AkshayLaddha943/Spherical-Bot/PCB files/PCB files/DATASHEETS/Motor driver TB66FNG-Robu/eagle_files for TB6612FNG/Readme.txt

The procurement of motordriver was done from Robu.in here https://robu.in/product/motor-driver-tb6612fng-module-performance-ultra-small-volume-3-pi-matching-performance-ultra-l298n/

But due to lack of required documentation on robu the similar product is available on spark fun here https://www.sparkfun.com/products/14451

I have provided the documents for the same of spark fun assuming the product to be same please go throught both for any query get in touch with me 
-Vaibhav N. Kadam
 7021781640/8976712648
 vaibhav02kadam@gmail.com/@iitb.ac.in
