AkshayLaddha943/Spherical-Bot/imgs/rpy_updated_2.PNG

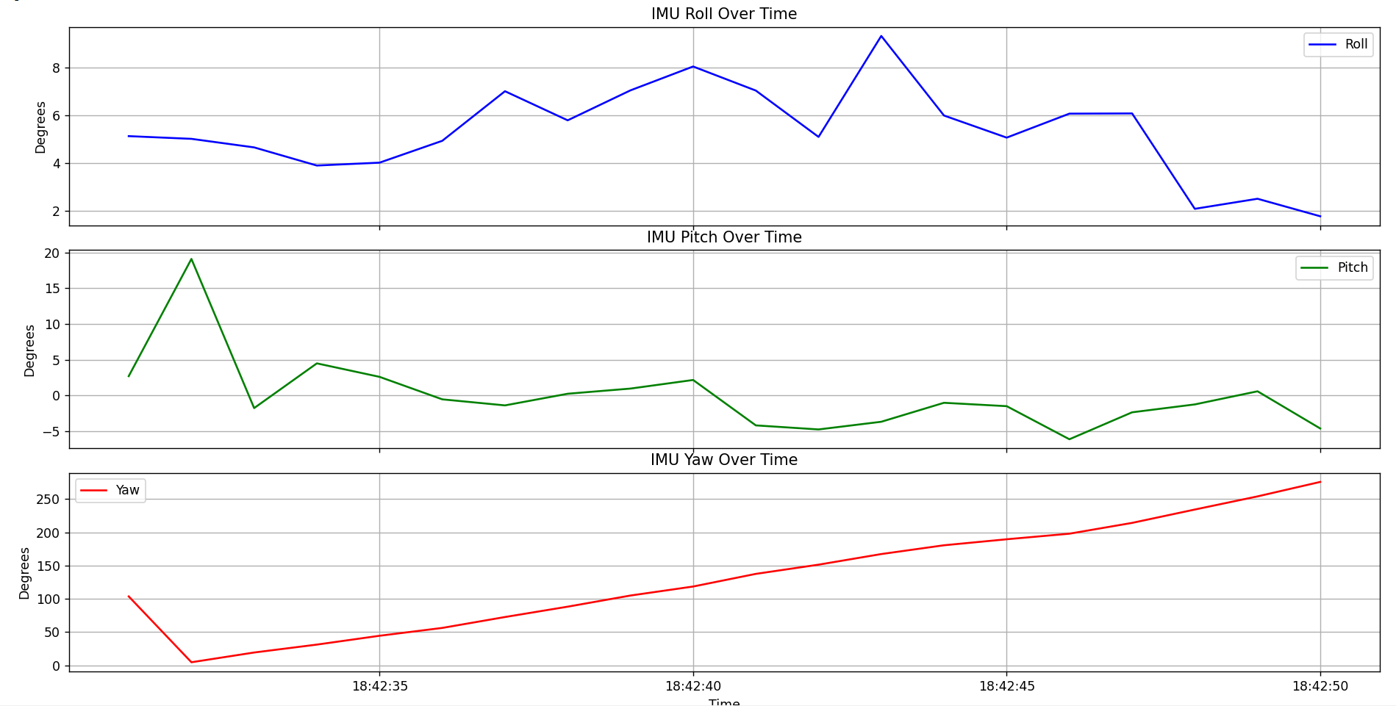
imgs/rpy_updated_2.PNG
