AkshayLaddha943/Spherical-Bot/PCB files/PCB files/DATASHEETS/0J4240.610_vSfLFW.jpeg

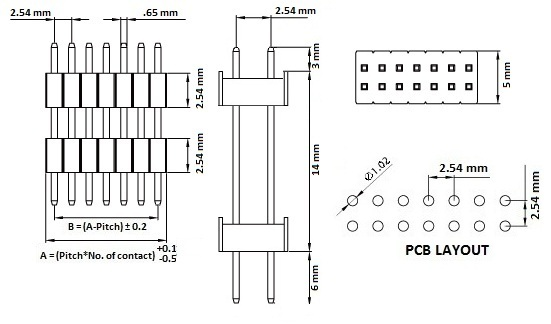
PCB files/PCB files/DATASHEETS/0J4240.610_vSfLFW.jpeg
