AkshayLaddha943/Spherical-Bot/PCB files/PCB files/DATASHEETS/41yIVpFrQML.jpeg.jpg

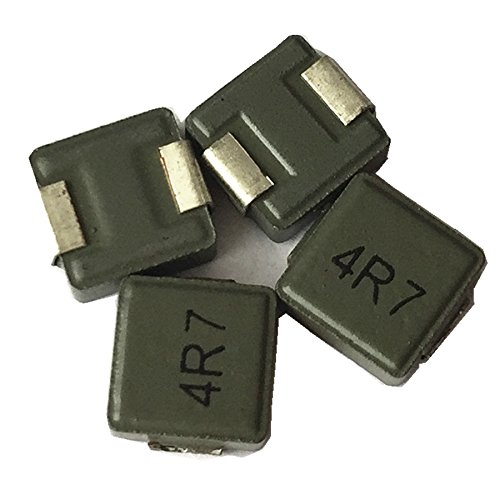
PCB files/PCB files/DATASHEETS/41yIVpFrQML.jpeg.jpg
