AkshayLaddha943/Spherical-Bot/PCB files/PCB files/DATASHEETS/adcpi_mechanical.png

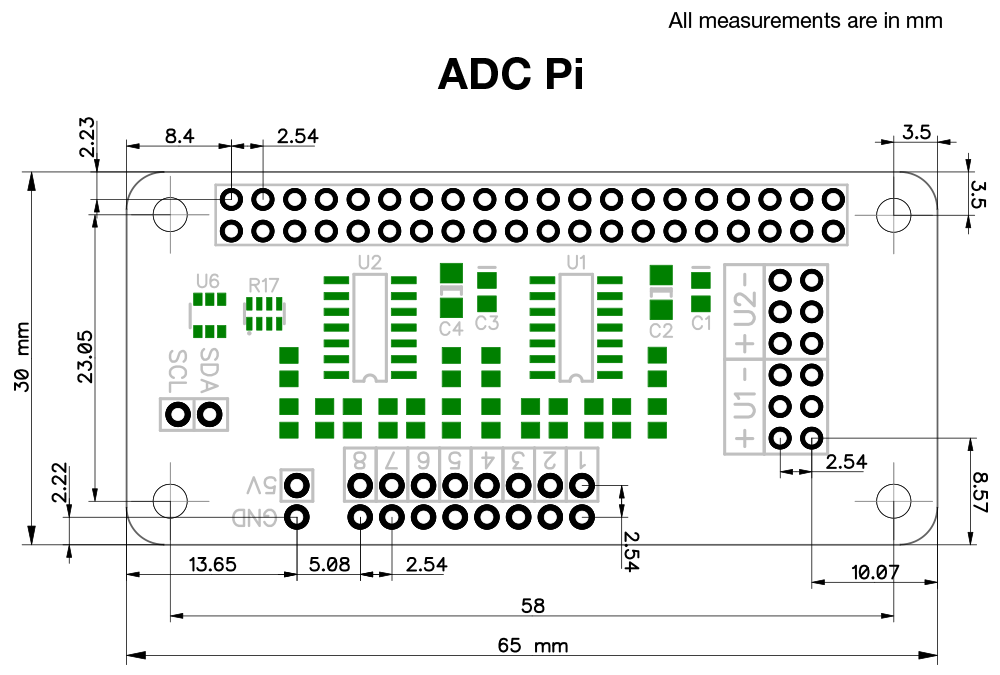
PCB files/PCB files/DATASHEETS/adcpi_mechanical.png
