AkshayLaddha943/Spherical-Bot/PCB files/PCB files/DATASHEETS/Barrel jack female Charging supply/footprint.png

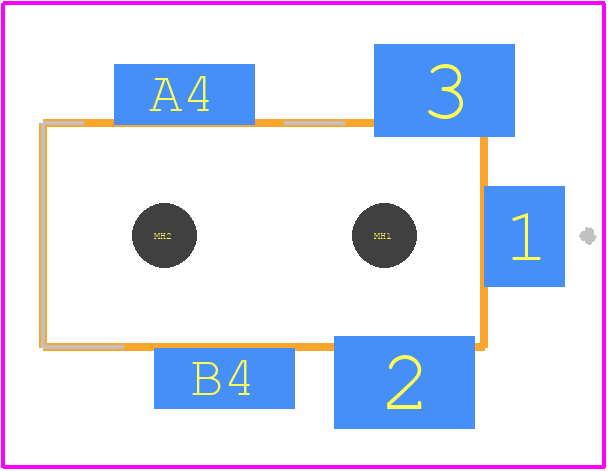
PCB files/PCB files/DATASHEETS/Barrel jack female Charging supply/footprint.png
