AkshayLaddha943/Spherical-Bot/PCB files/PCB files/DATASHEETS/DIP SW/upload_105_295_23274611.jpg

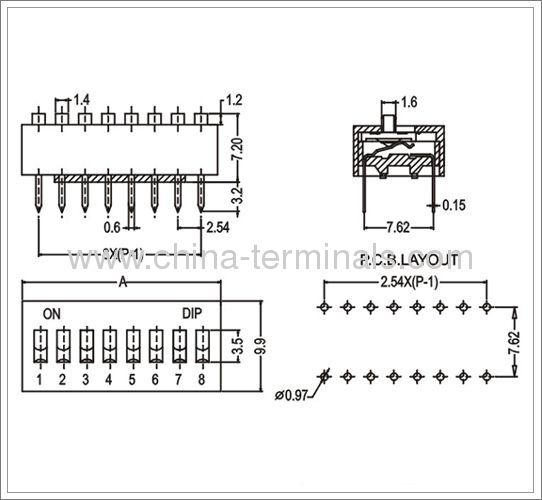
PCB files/PCB files/DATASHEETS/DIP SW/upload_105_295_23274611.jpg
