AkshayLaddha943/Spherical-Bot/PCB files/PCB files/DATASHEETS/power-jack-symbol.png

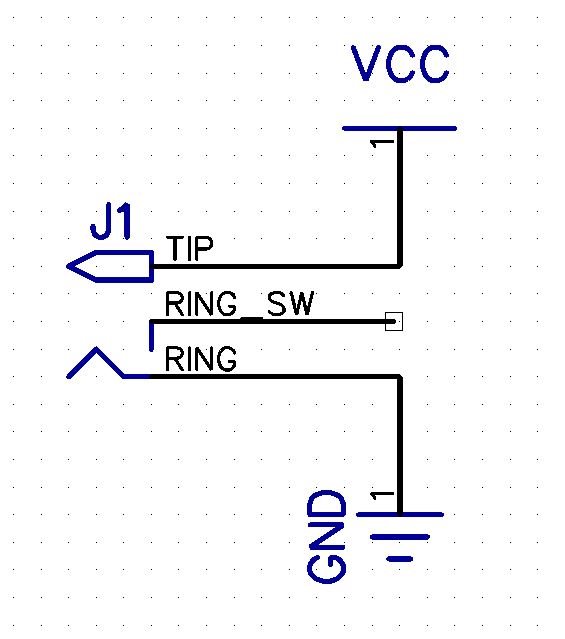
PCB files/PCB files/DATASHEETS/power-jack-symbol.png
