AkshayLaddha943/Spherical-Bot/PCB files/PCB files/LAYOUT/Bottom.jpeg

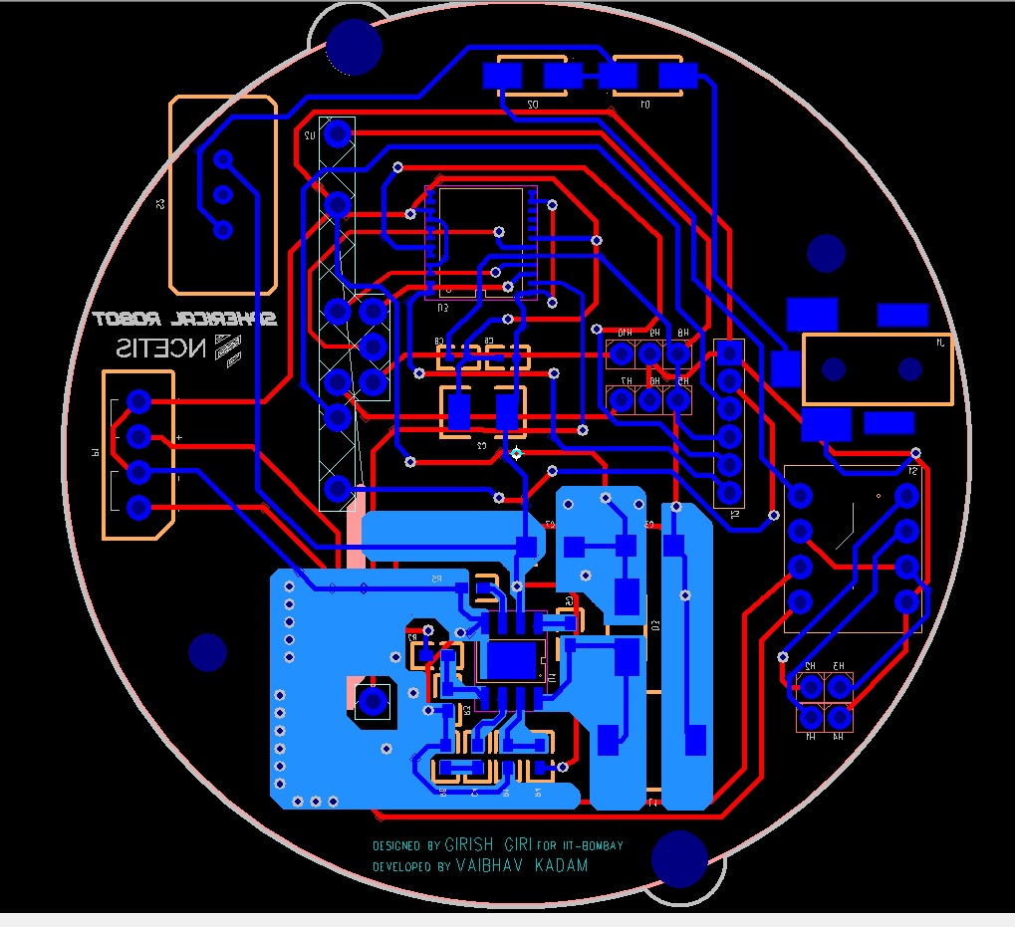
PCB files/PCB files/LAYOUT/Bottom.jpeg
