AkshayLaddha943/Spherical-Bot/PCB files/PCB files/LAYOUT/TOP.jpeg

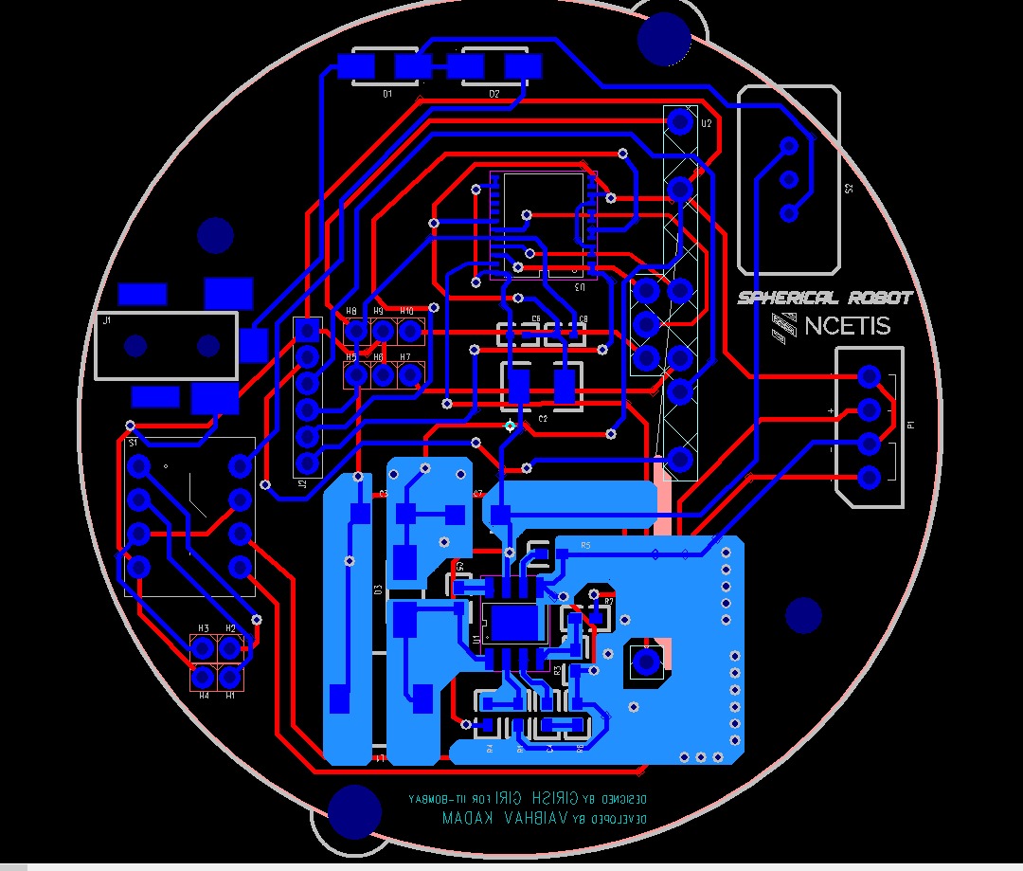
PCB files/PCB files/LAYOUT/TOP.jpeg
