AkshayLaddha943/Spherical-Bot/PCB files/PCB files/DATASHEETS/BUCK DATASHEETS BOM/IMP LINKS and BOM.txt

For BOM
https://easyeda.com/Yant/MP1584-521997582e3f466eb2dd6343b7ac5e77
