AkshayLaddha943/Spherical-Bot/PCB files/PCB files/EPSPCB_BOM_VAIBHAV.jpg

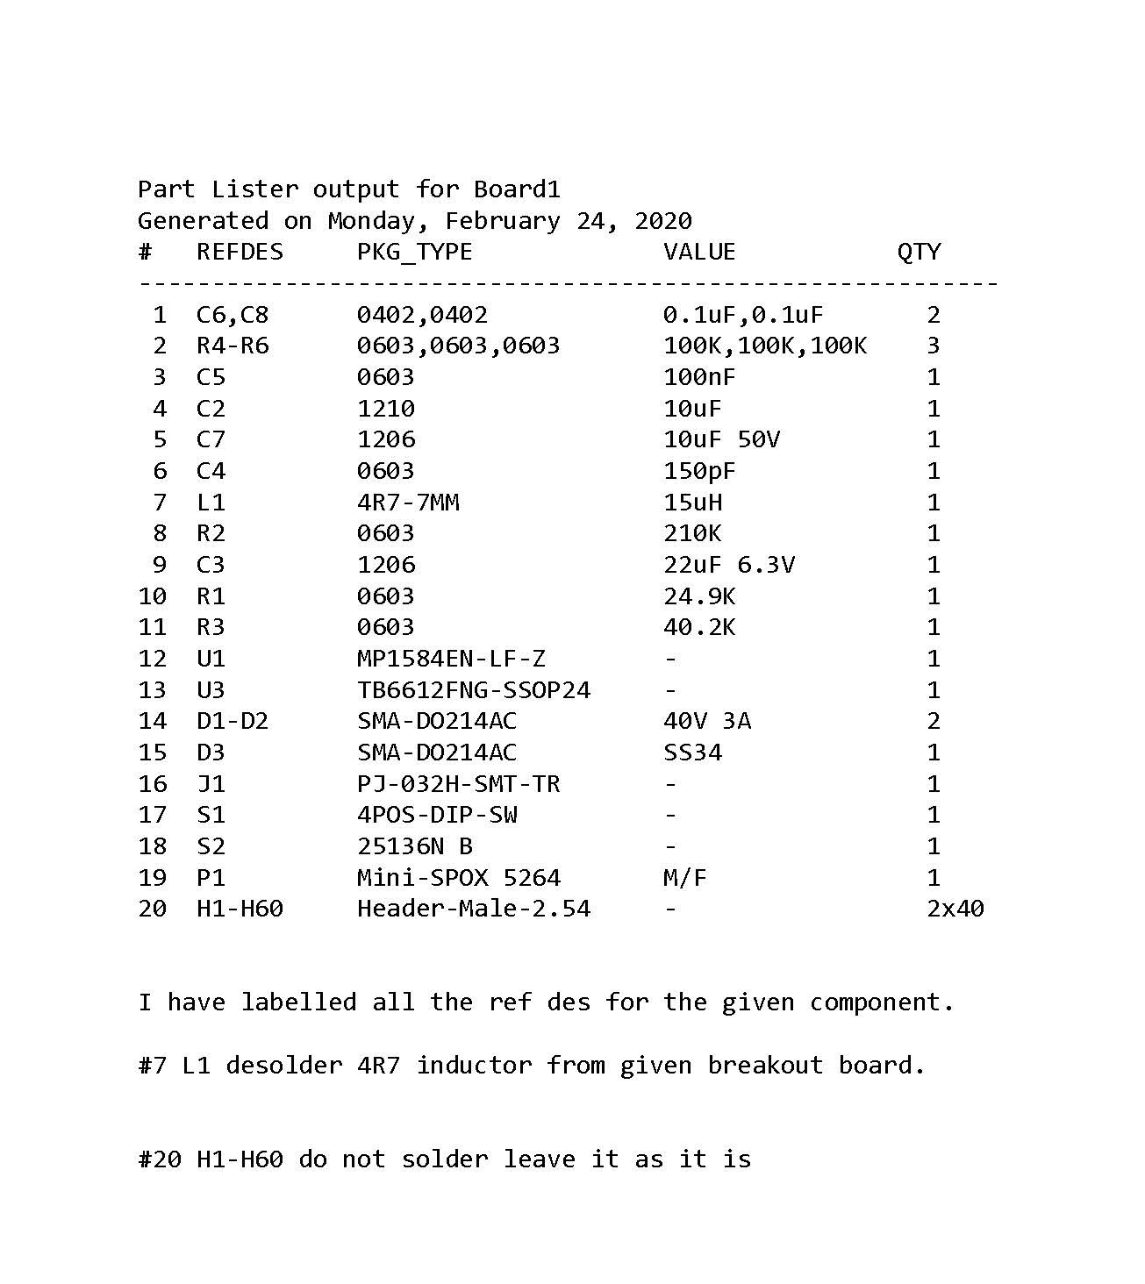
PCB files/PCB files/EPSPCB_BOM_VAIBHAV.jpg
