AkshayLaddha943/Spherical-Bot/PCB files/PCB files/CAD ASSEMBLEY/FINAL PCB CAD/sb.SLDASM

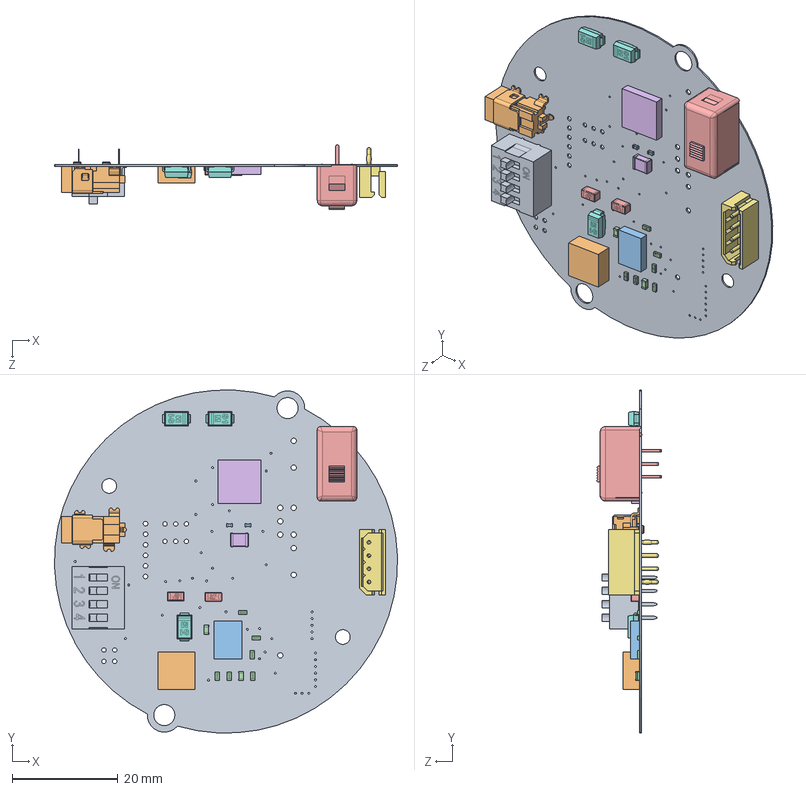
[picture p28: CAD file, 2024-07-29]
PCB files/PCB files/CAD ASSEMBLEY/FINAL PCB CAD/sb.SLDASM
65.0 x 64.9 x 12.2 mm
sb
pj-032h-smt-tr
0402c_2320560 x 2
0603C x 2
Capacitor Vishay 1206 X7R x 2
CAP1210
PORT
DO-214AC x 3
DS-4
inductor7mm
SOIC8_MP1584_BUCK_MP1584_BUCK
0603_RES x 6
25136nab
SSOP24_TB6612FNG_MTR_DRVR_TB6612FNG_MD
