AkshayLaddha943/Spherical-Bot/PCB files/PCB files/DATASHEETS/Barrel jack female Charging supply/CAD/pj-032h-smt-tr.SLDASM

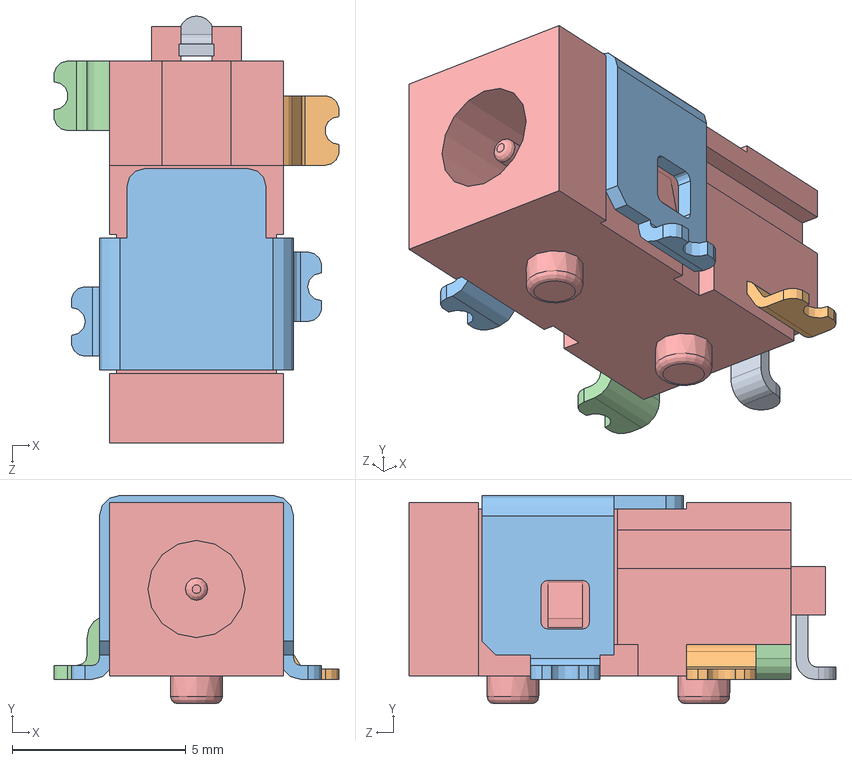
[picture p29: CAD file, 2024-07-29]
PCB files/PCB files/DATASHEETS/Barrel jack female Charging supply/CAD/pj-032h-smt-tr.SLDASM
8.20 x 6.00 x 12.3 mm
pj-032h-smt-tr_01
pj-032h-smt-tr_02
pj-032h-smt-tr_03
pj-032h-smt-tr_04
pj-032h-smt-tr_05
