AkshayLaddha943/Spherical-Bot/PCB files/PCB files/CAD ASSEMBLEY/PCB_Placement.SLDASM

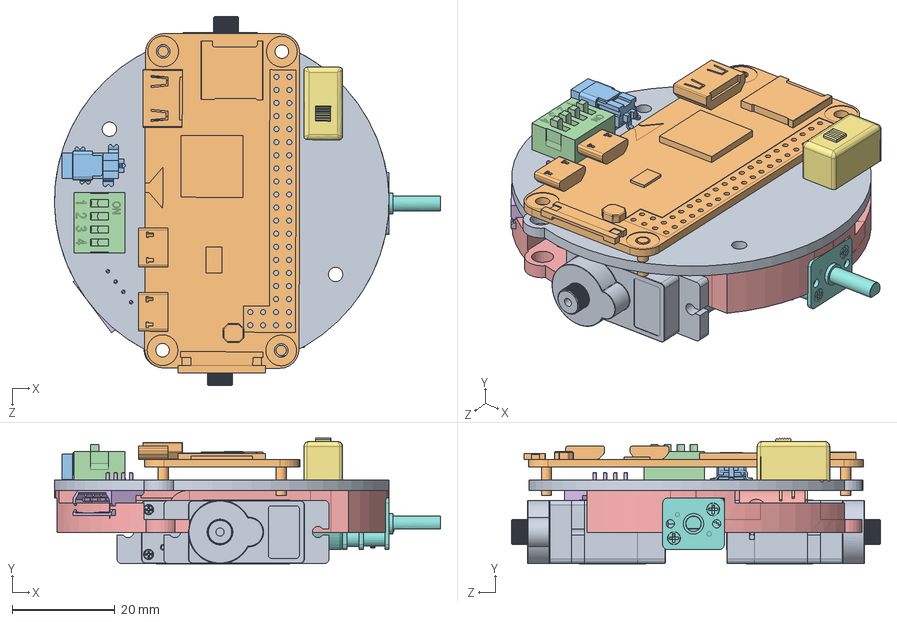
[picture p30: CAD file, 2024-07-29]
PCB files/PCB files/CAD ASSEMBLEY/PCB_Placement.SLDASM
75.0 x 24.5 x 71.7 mm
PCB_Placement
Pi_Zero_W
Barrel_jack
DS-4
25136nab
N20_motor_magnetic_encoder
Servo_motor x 2
