AkshayLaddha943/Spherical-Bot/PCB files/PCB files/CAD ASSEMBLEY/Part1.DXF

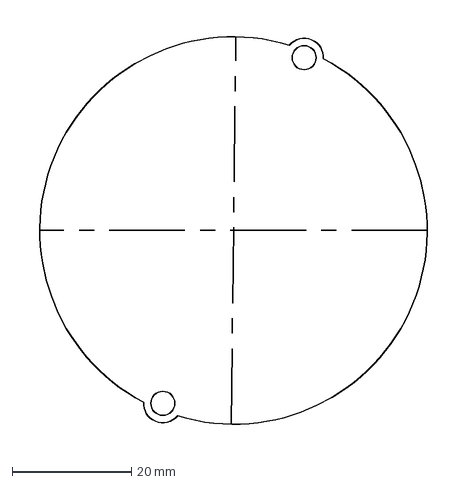
[picture p31: CAD file, 2024-07-29]
PCB files/PCB files/CAD ASSEMBLEY/Part1.DXF
72.8 x 71.9 mm
