AkshayLaddha943/Spherical-Bot/PCB files/PCB files/DATASHEETS/N20 Motor and encoder/Pololu/Motor/micro-metal-gearmotor-extended-with-1086-bracket.step

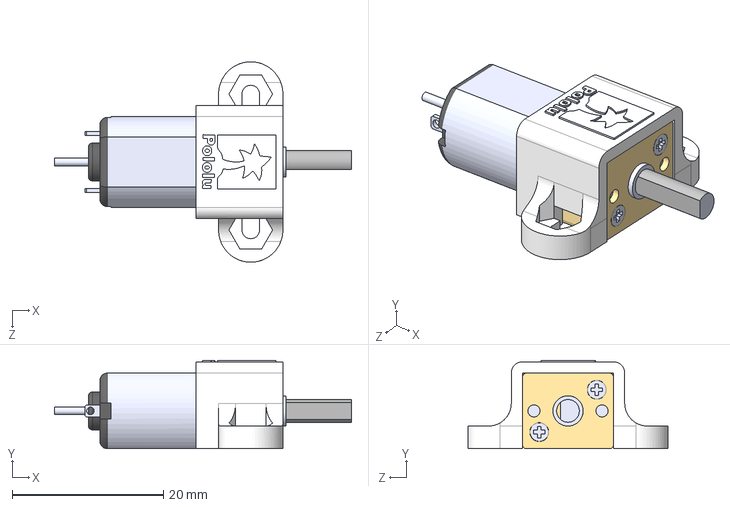
[picture p32: CAD file, 2024-07-29]
PCB files/PCB files/DATASHEETS/N20 Motor and encoder/Pololu/Motor/micro-metal-gearmotor-extended-with-1086-bracket.step
39.3 x 11.7 x 26.5 mm
