AkshayLaddha943/Spherical-Bot/PCB files/PCB files/CAD ASSEMBLEY/Yoke_Upper_PCB.SLDPRT

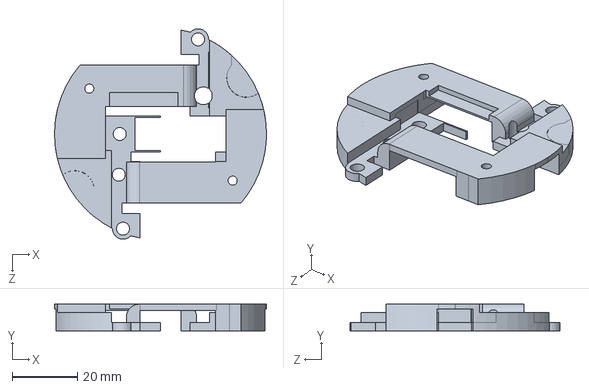
[picture p33: CAD file, 2024-07-29]
PCB files/PCB files/CAD ASSEMBLEY/Yoke_Upper_PCB.SLDPRT
65.0 x 8.20 x 64.5 mm
