AkshayLaddha943/Spherical-Bot/PCB files/PCB files/CAD ASSEMBLEY/PCB_Layout_plan.DXF

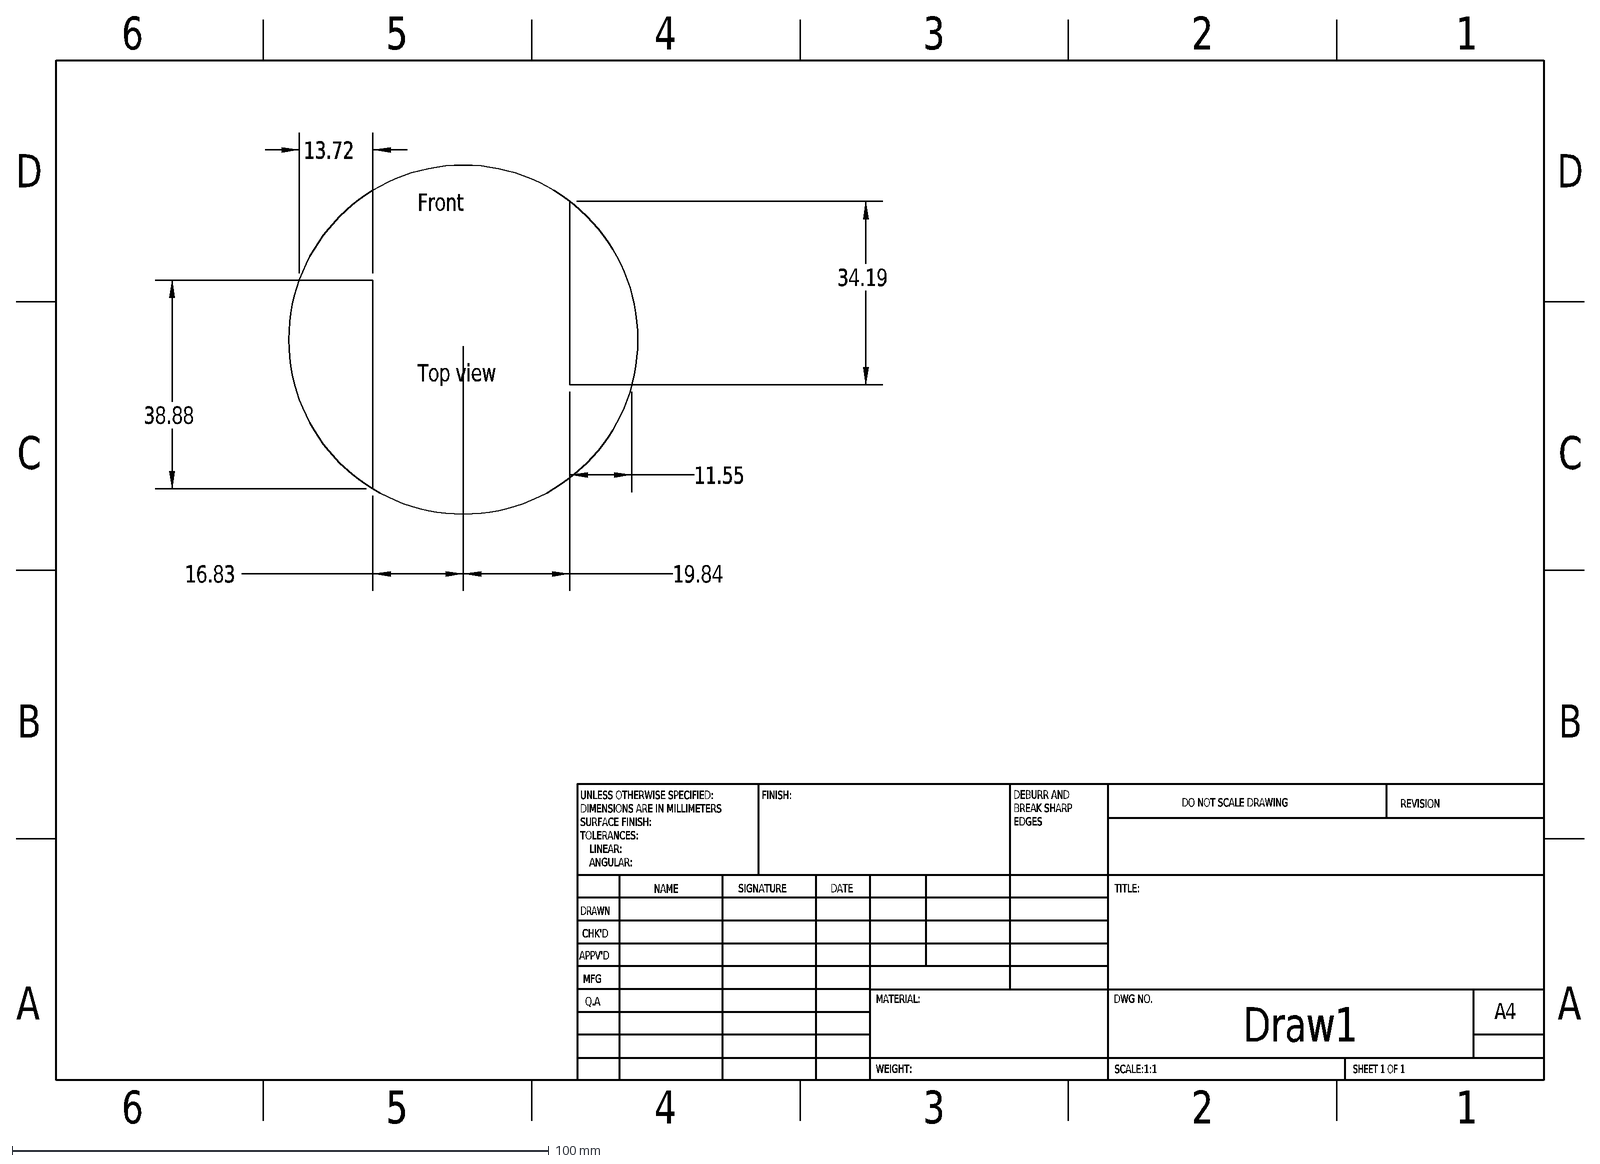
[picture p34: CAD file, 2024-07-29]
PCB files/PCB files/CAD ASSEMBLEY/PCB_Layout_plan.DXF
38.88
11.55
34.19
13.72
19.84
16.83
Top view
Front
A
B
C
D
6
5
4
3
2
1
DRAWN
CHK'D
APPV'D
MFG
Q.A
UNLESS OTHERWISE SPECIFIED:
DIMENSIONS ARE IN MILLIMETERS
SURFACE FINISH:
TOLERANCES:
LINEAR:
ANGULAR:
FINISH:
DEBURR AND
BREAK SHARP
EDGES
NAME
SIGNATURE
DATE
MATERIAL:
DO NOT SCALE DRAWING
REVISION
TITLE:
DWG NO.
SCALE:1:1
SHEET 1 OF 1
A4
WEIGHT:
Draw1
