AkshayLaddha943/Spherical-Bot/PCB files/PCB files/DATASHEETS/Sliding switch Battery and power/25136nab FLUSH ACTUATOR.SLDPRT

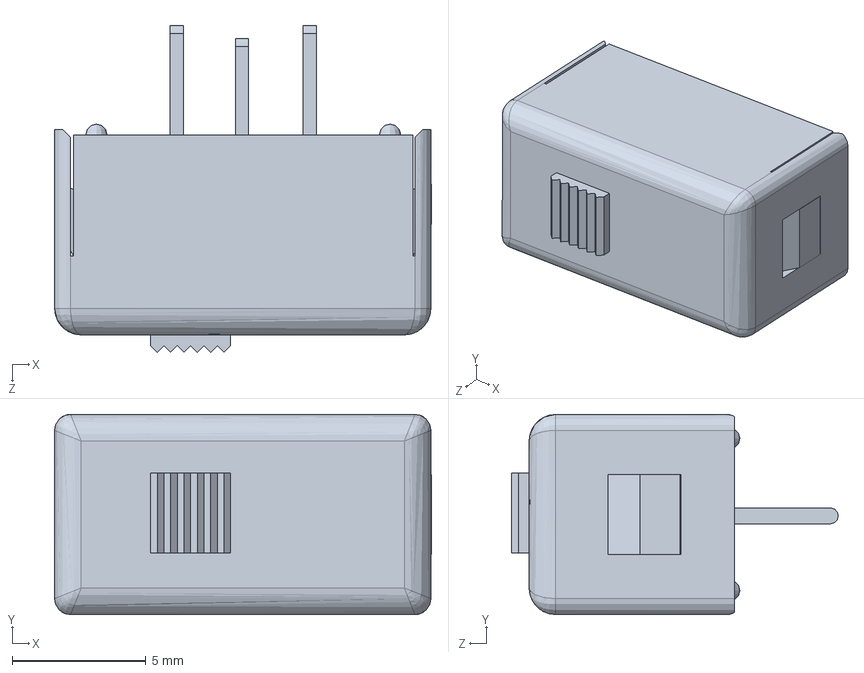
[picture p35: CAD file, 2024-07-29]
PCB files/PCB files/DATASHEETS/Sliding switch Battery and power/25136nab FLUSH ACTUATOR.SLDPRT
14.1 x 7.50 x 12.2 mm
