AkshayLaddha943/Spherical-Bot/PCB files/PCB files/DATASHEETS/SPOX Wire-to-Board and BMI Connectors/050375043.stp

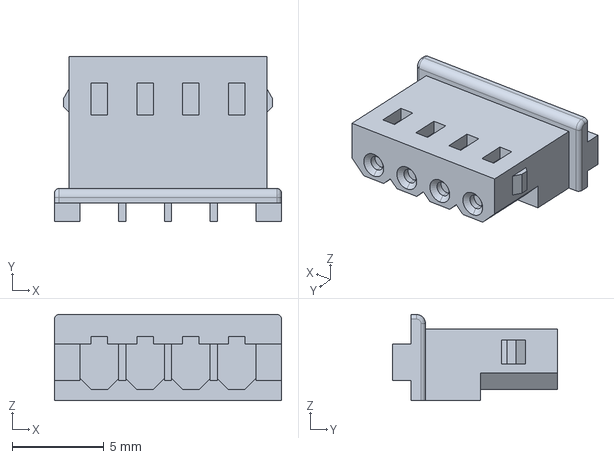
[picture p36: CAD file, 2024-07-29]
PCB files/PCB files/DATASHEETS/SPOX Wire-to-Board and BMI Connectors/050375043.stp
12.4 x 9.00 x 4.70 mm
