AkshayLaddha943/Spherical-Bot/PCB files/PCB files/DATASHEETS/SPOX Wire-to-Board and BMI Connectors/099990988.stp

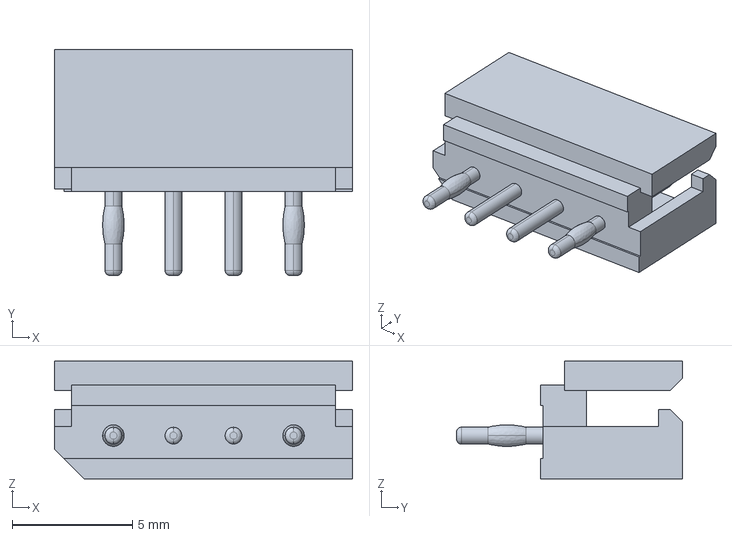
[picture p37: CAD file, 2024-07-29]
PCB files/PCB files/DATASHEETS/SPOX Wire-to-Board and BMI Connectors/099990988.stp
12.4 x 9.40 x 4.90 mm
