AkshayLaddha943/Spherical-Bot/(list of files, cad)

Other CAD files:
PCB files/PCB files/CAD ASSEMBLEY/FINAL PCB CAD/sphericalbot.SLDPRT
PCB files/PCB files/DATASHEETS/Barrel jack female Charging supply/CAD/pj-032h-smt-tr_04.SLDPRT
PCB files/PCB files/DATASHEETS/Barrel jack female Charging supply/CAD/pj-032h-smt-tr_03.SLDPRT
PCB files/PCB files/DATASHEETS/Barrel jack female Charging supply/CAD/pj-032h-smt-tr_02.SLDPRT
PCB files/PCB files/DATASHEETS/Barrel jack female Charging supply/CAD/pj-032h-smt-tr_01.SLDPRT
PCB files/PCB files/DATASHEETS/Barrel jack female Charging supply/CAD/pj-032h-smt-tr_05.SLDPRT
PCB files/PCB files/CAD ASSEMBLEY/PCB_Layout_plan.SLDDRW
PCB files/PCB files/CAD ASSEMBLEY/PCB_Placement.SLDPRT
