AkshayLaddha943/Spherical-Bot/PCB files/PCB files/CAD ASSEMBLEY/PCB_Layout_plan.JPG

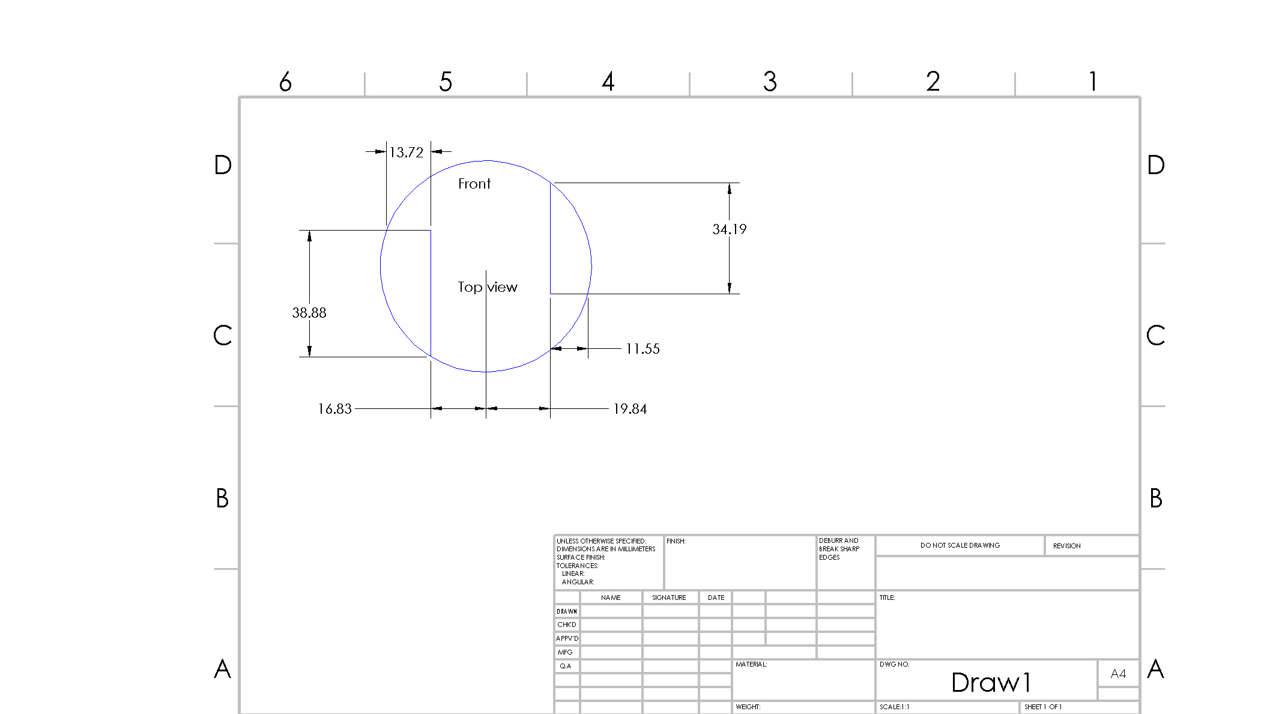
PCB files/PCB files/CAD ASSEMBLEY/PCB_Layout_plan.JPG
