AkshayLaddha943/Spherical-Bot/PCB files/PCB files/CAD ASSEMBLEY/WhatsApp Image 2020-02-27 at 4.58.12 PM.jpeg

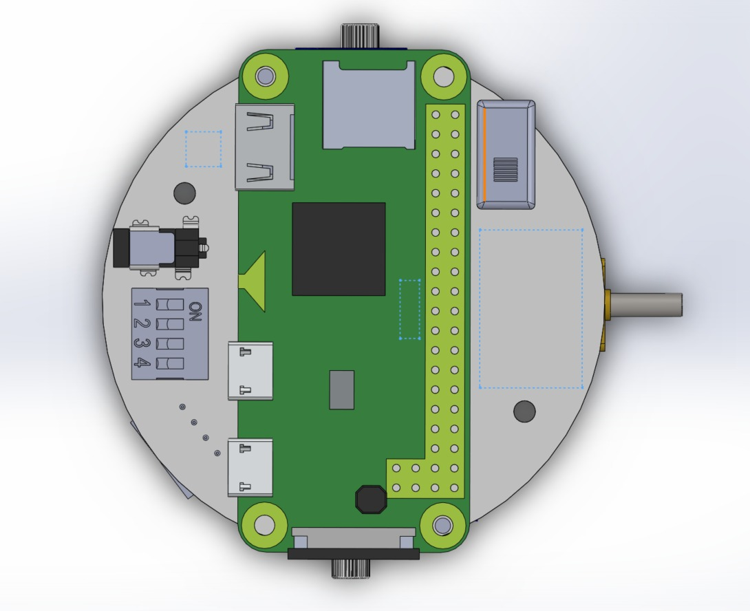
PCB files/PCB files/CAD ASSEMBLEY/WhatsApp Image 2020-02-27 at 4.58.12 PM.jpeg
