AkshayLaddha943/Spherical-Bot/PCB files/PCB files/CAD ASSEMBLEY/WhatsApp Image 2020-02-27 at 4.59.00 PM.jpeg

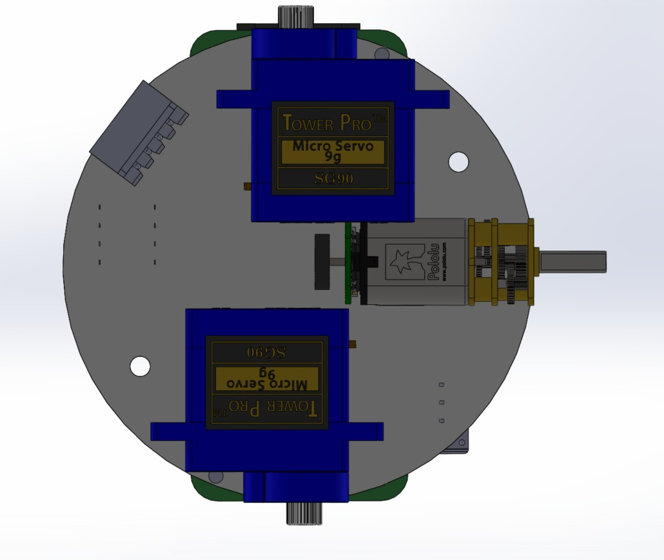
PCB files/PCB files/CAD ASSEMBLEY/WhatsApp Image 2020-02-27 at 4.59.00 PM.jpeg
