AkshayLaddha943/Spherical-Bot/PCB files/PCB files/CAD ASSEMBLEY/WhatsApp Image 2020-03-08 at 8.14.50 PM.jpeg

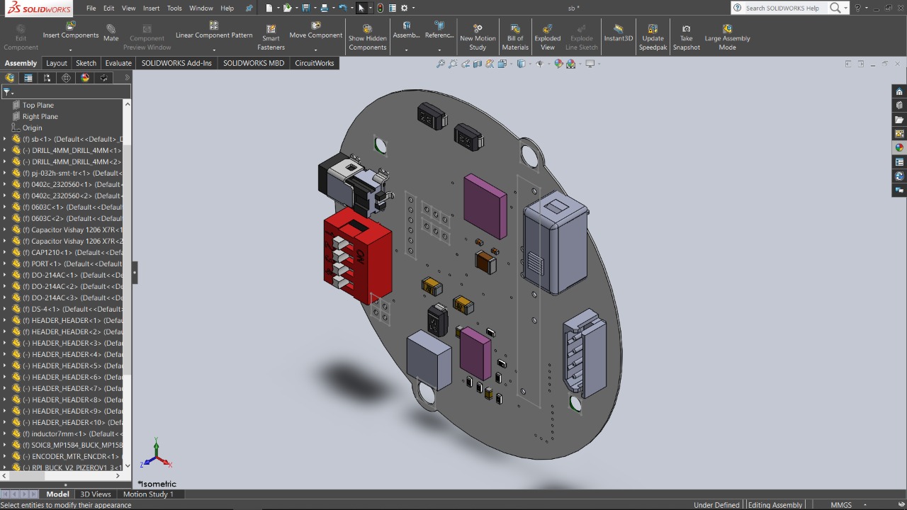
PCB files/PCB files/CAD ASSEMBLEY/WhatsApp Image 2020-03-08 at 8.14.50 PM.jpeg
