AkshayLaddha943/Spherical-Bot/PCB files/PCB files/PCB EXCEPTIONS PCB POWER/How to Order/Stencil preference.jpeg

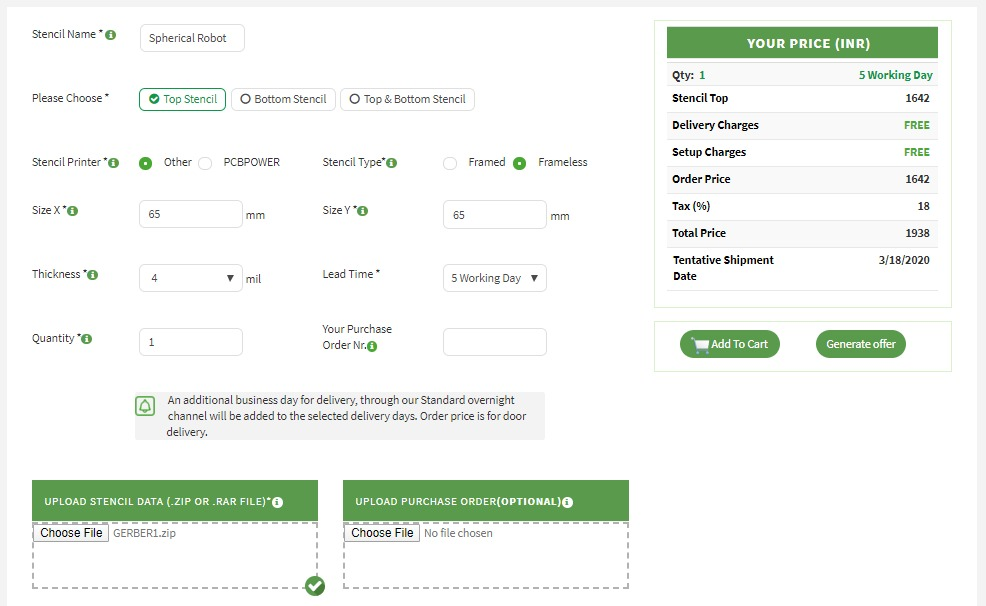
PCB files/PCB files/PCB EXCEPTIONS PCB POWER/How to Order/Stencil preference.jpeg
