AkshayLaddha943/Spherical-Bot/PCB files/PCB files/SCH/proto2_smd_schematic_diagram.pdf

U1 8 5

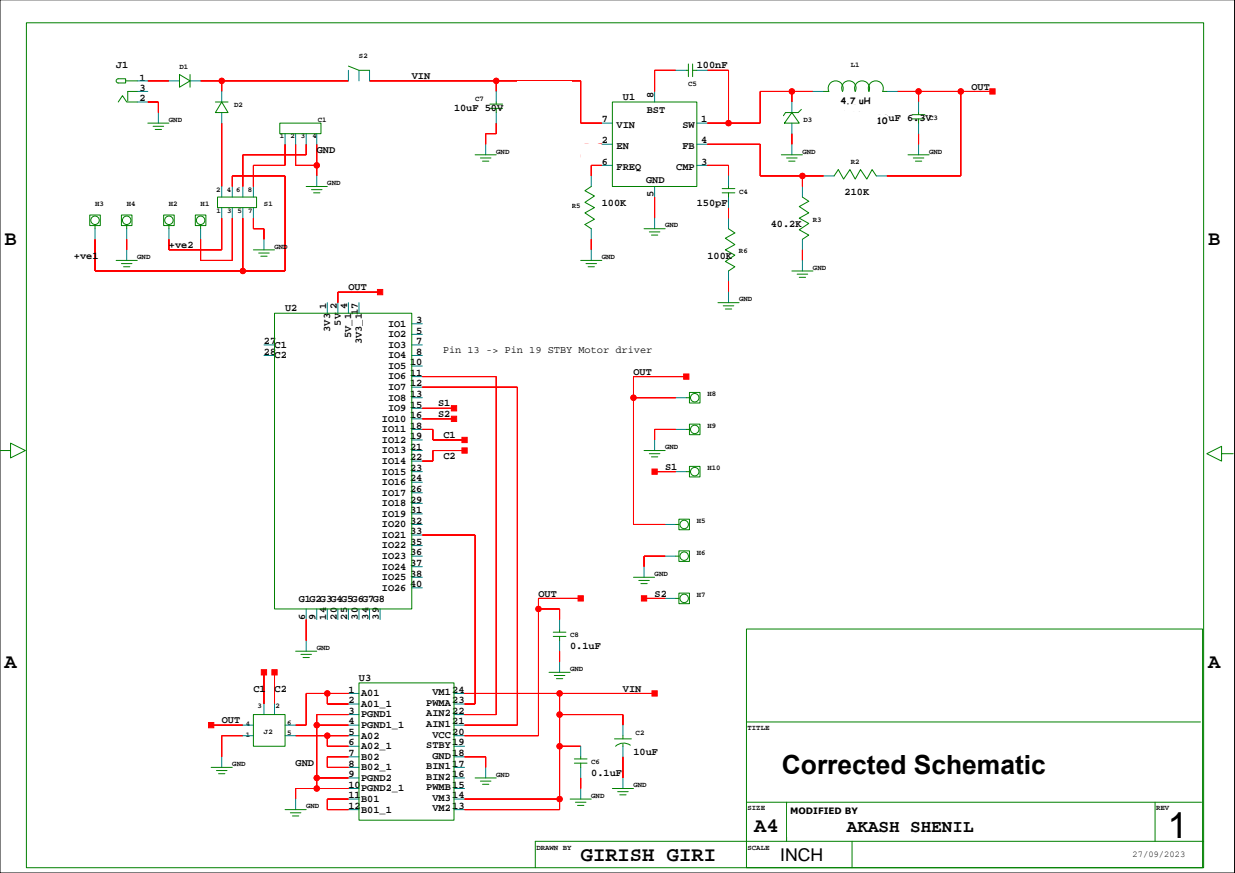
[picture p44: page 1]

Pin 13 -> Pin 19 STBY Motor driver

modified by Akash Shenil
AKASH SHENIL
