AkshayLaddha943/Spherical-Bot/PCB files/PCB files/CAD ASSEMBLEY/PCB_Layout_plan_27_2-20.PDF

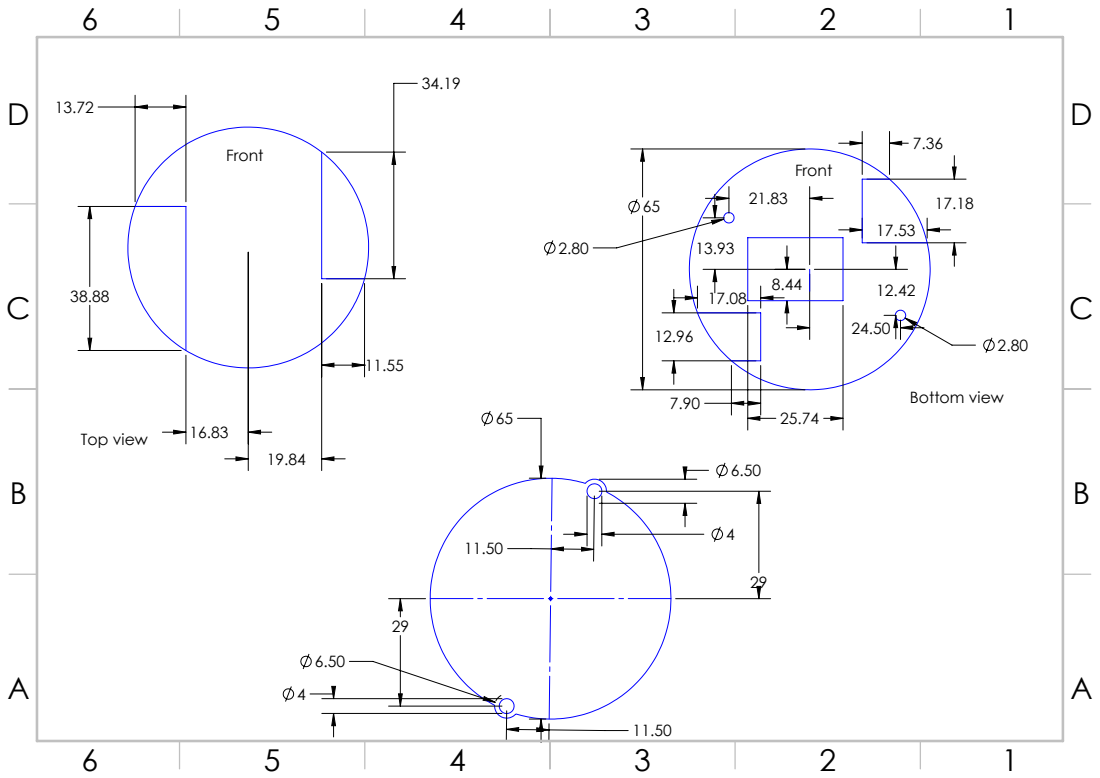
[picture p45: page 1]
Top view; Bottom view
