AkshayLaddha943/Spherical-Bot/PCB files/PCB files/LAYOUT/SB.pdf

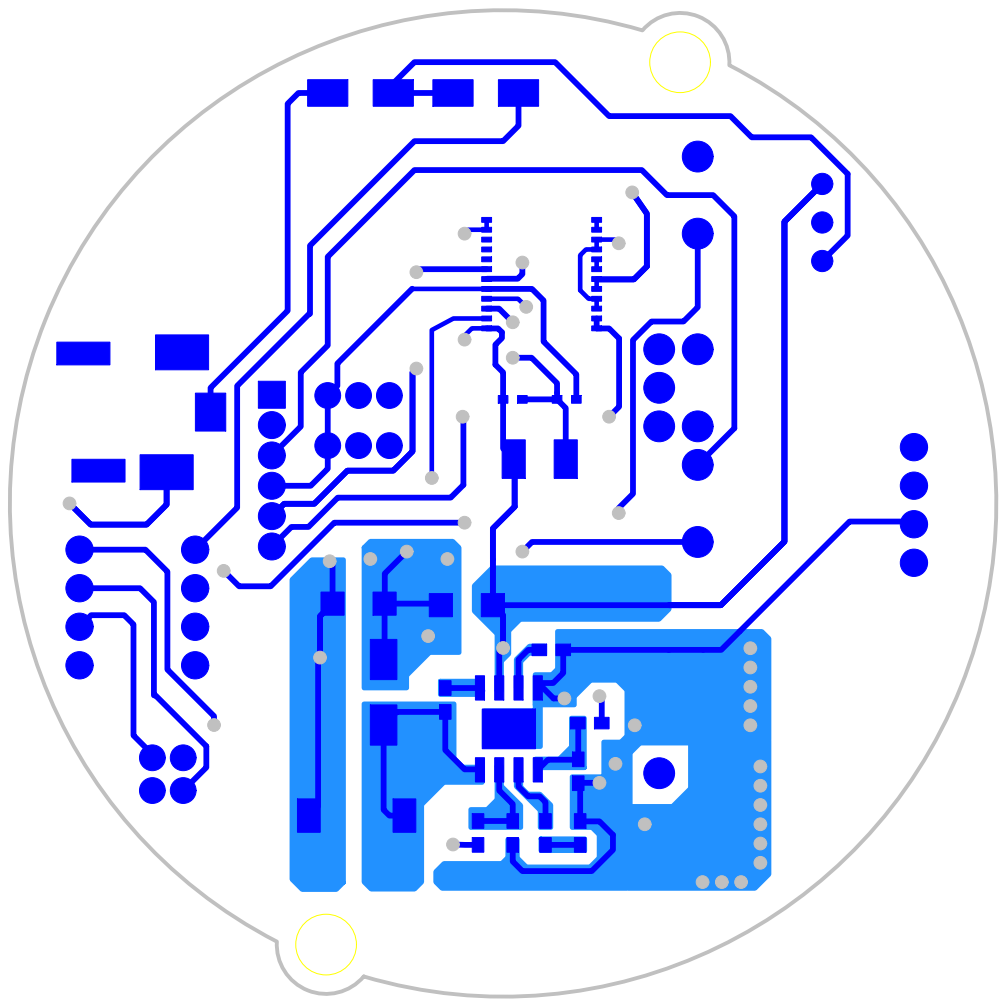
[picture p46: page 1]
C6C⁶x1; C⁶x2; C8C⁸x2; C⁸x1; C4C⁴x1 C⁴x2; C5C⁵x1 C⁵x2; C3C³x1; C³x2; C7C⁷x2; C⁷x1 C2C²x1; C²x2; P1P¹x1 P¹x2 P¹x3 P¹x4; D1D¹x2; D¹x1; D2D²x1; D²x2; D3D³x1 D³x2; S1S¹x1; S¹x2 S¹x3; S¹x4 S¹x5; S¹x6 S¹x7; S¹x8; H1H¹x1; H3H³x1 H2H²x1 H4H⁴x1; H5H⁵x1 H6H⁶x1 H7H⁷x1; H8H⁸x1 H9H⁹x1 H10H¹⁰x1; U1U¹x1; U¹x2; U¹x3; U¹x4 U¹x8; U¹x7; U¹x6; U¹x5 U¹x9; U2U²x2 U²x6 U²x11 U²x12 U²x13 U²x15 U²x16 U²x18 U²x22 U²x33; R1R¹x1 R¹x2; R2R²x1; R²x2; R3R³x1 R³x2; R4R⁴x1 R⁴x2; R5R⁵x2; R⁵x1 R6R⁶x1 R⁶x2; S2S²x1 S²x2 S²x3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

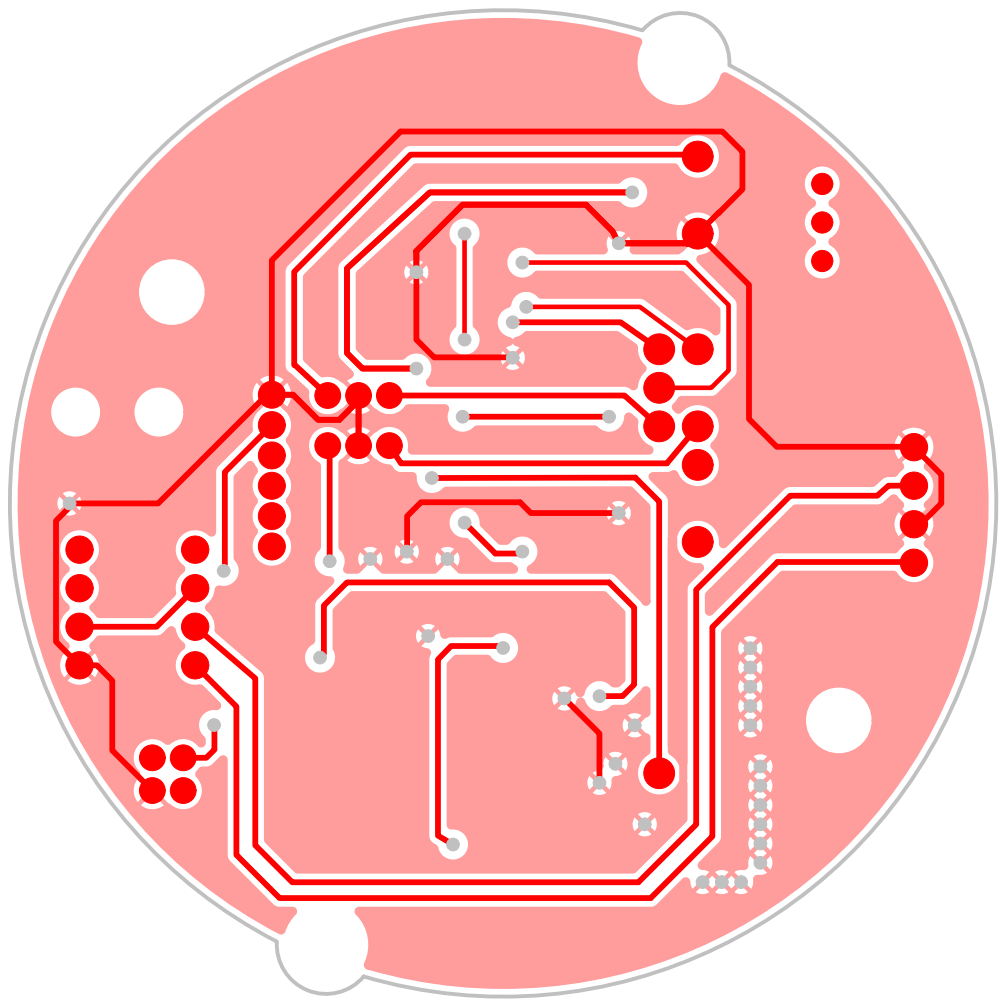
[picture p47: page 2]
P1P¹x1 P¹x2 P¹x3 P¹x4; S1S¹x1; S¹x2 S¹x3; S¹x4 S¹x5; S¹x6 S¹x7; S¹x8; H1H¹x1; H3H³x1 H2H²x1 H4H⁴x1; H5H⁵x1 H6H⁶x1 H7H⁷x1; H8H⁸x1 H9H⁹x1 H10H¹⁰x1; U2U²x2 U²x6 U²x11 U²x12 U²x13 U²x15 U²x16 U²x18 U²x22 U²x33; S2S²x1 S²x2 S²x3

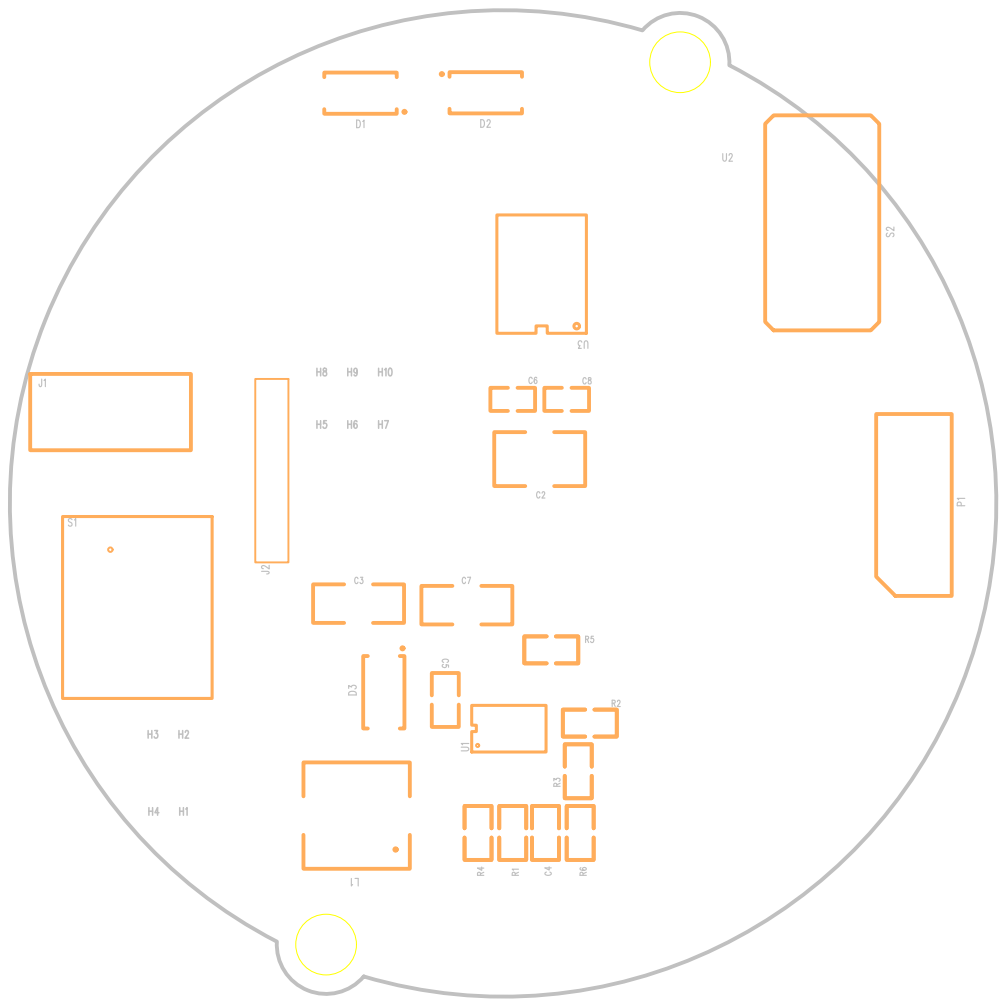
[picture p48: page 3]

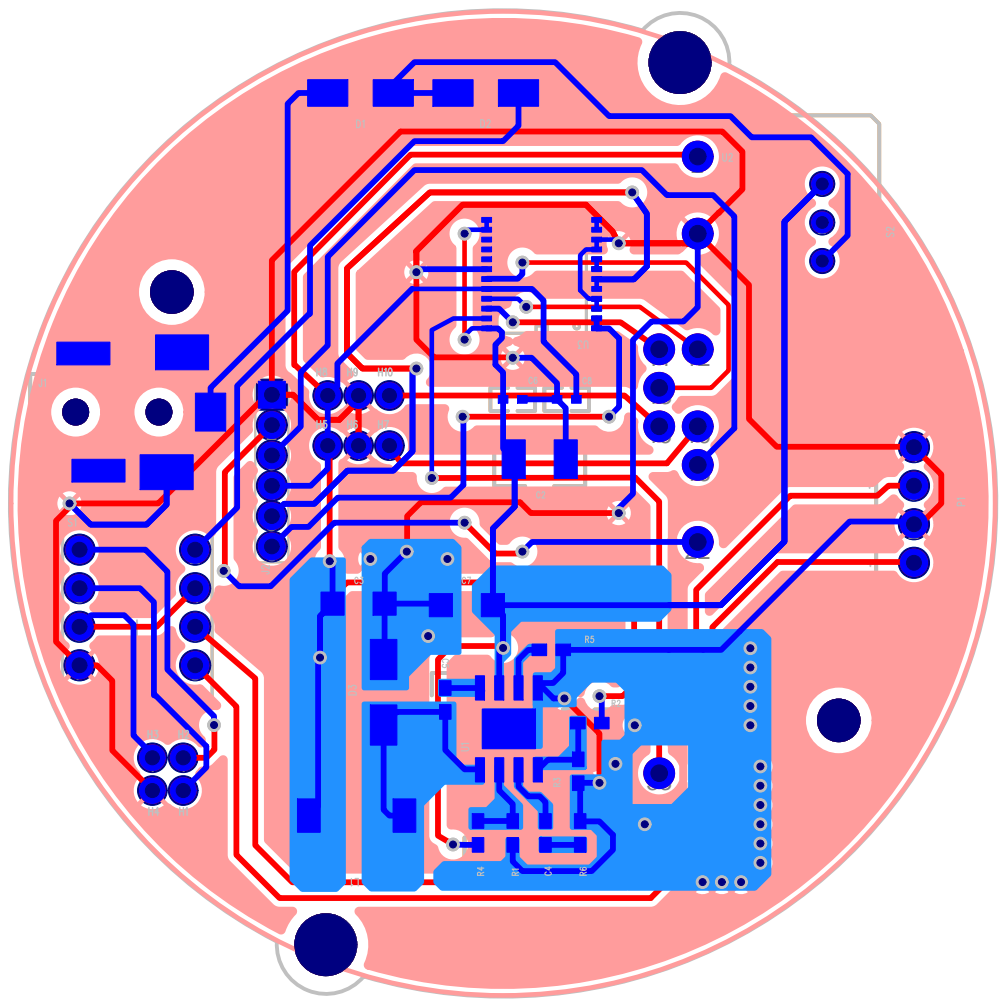
[picture p49: page 5]
