AkshayLaddha943/Spherical-Bot/PCB files/PCB files/PCB EXCEPTIONS PCB POWER/432375-outline.pdf

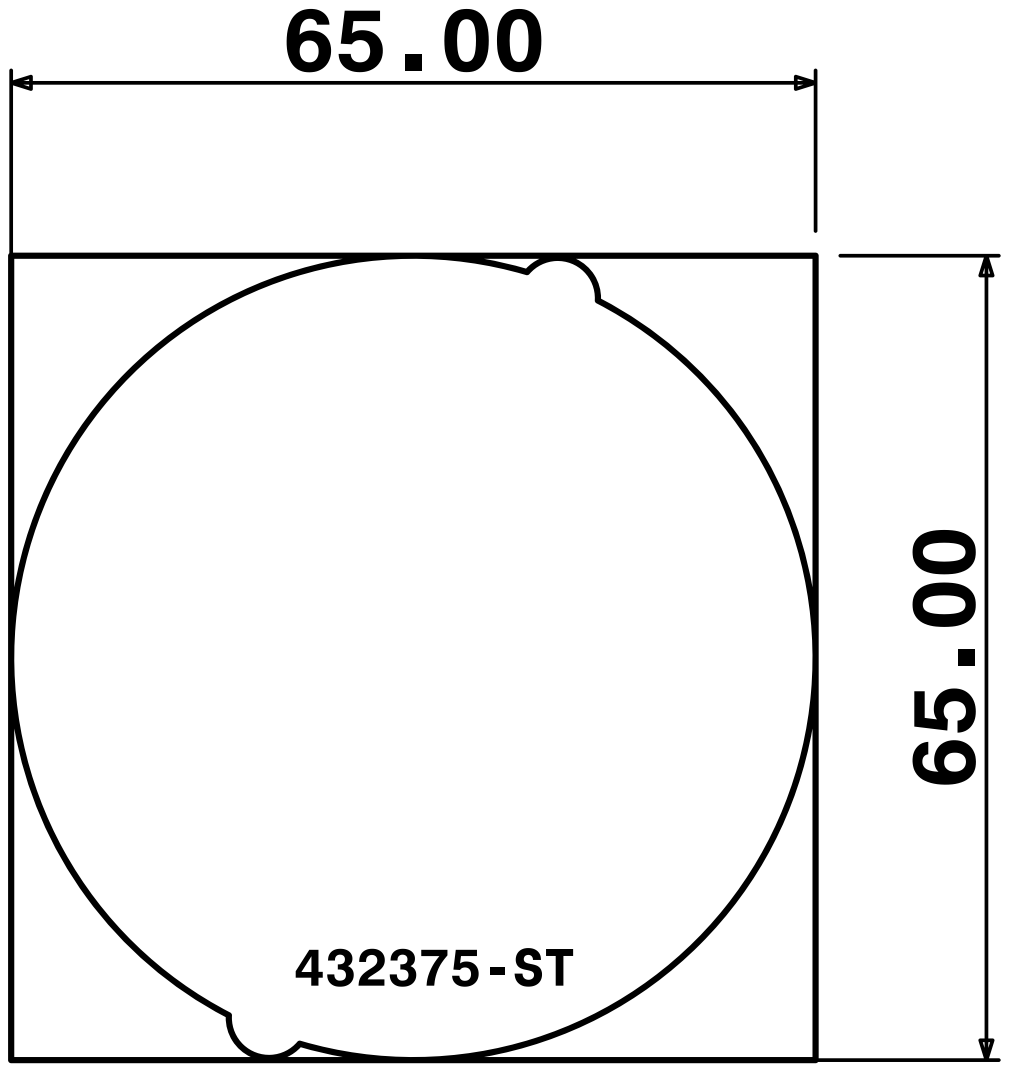
[picture p50: page 1]
