AkshayLaddha943/Spherical-Bot/(list of files, drawings)

Other design files:
PCB files/PCB files/DATASHEETS/Motor driver TB66FNG-Robu/eagle_files for TB6612FNG/Imported SparkFun_Motor_Driver-TB6612FNG_v11c.PrjPCB/SparkFun_Motor_Driver-TB6612FNG_v11c.PrjPCB
PCB files/PCB files/DATASHEETS/Motor driver TB66FNG-Robu/eagle_files for TB6612FNG/Imported SparkFun_Motor_Driver-TB6612FNG_v11c.PrjPCB/SparkFun_Motor_Driver-TB6612FNG_v11c.SchDoc
PCB files/PCB files/DATASHEETS/Motor driver TB66FNG-Robu/eagle_files for TB6612FNG/Imported SparkFun_Motor_Driver-TB6612FNG_v11c.PrjPCB/SparkFun_Motor_Driver-TB6612FNG_v11c.SchDoc_Template.SchDoc
